JPlane6/Pulse/requirements_pi.txt

# ============================================================
#  PULSE — Raspberry Pi (Robot Client) Requirements
#
#  HOW TO INSTALL
#    If using a virtual environment (VENV):
#      pip install -r requirements_pi.txt
#
#    If installing globally to system packages:
#      pip install -r requirements_pi.txt --break-system-packages
# ============================================================

# ============================================================
#  PIP PACKAGES
# ============================================================

requests
# Sends audio data and history JSON structures to your Mac server.

pyserial
# Serial interface link between the Pi and the Arduino Mega motor driver.

RPLCD
# High-level character driver for the 20x4 I2C LCD screen.

smbus2
# Underpinning I2C system communication link for RPLCD layer calls.

sounddevice
# Handles safe 48kHz audio recordings from the USB headset mic.

scipy
# Downsamples audio streams dynamically to 16kHz via signal processing profiles.

numpy
# Array library facilitating multi-channel wave data processing.

opencv-python
# Retained fallback layer for image captures and diagnostic testing.

torch
# Required on the Pi to process local Silero VAD frame computations.

silero-vad
# Dynamic silence threshold iterator to eliminate fixed audio recording caps.

gpiod
# Allows Pi to use GPIO pins to run the status LEDs natively.

# ============================================================
#  CANNOT BE INSTALLED WITH PIP
#  Set these up manually before running client.py or main.py.
# ============================================================

# ------------------------------------------------------------
#  SYSTEM DEPENDENCIES & ALSA UTILITIES
# ------------------------------------------------------------
# Run these terminal operations to configure base image tools:
#   sudo apt-get update
#   sudo apt-get install -y i2c-tools python3-dev cmake swig libgfortran5 libatlas-base-dev libgpiod-dev aplay arecord

# ------------------------------------------------------------
#  I2C BUS CONFIGURATION (LCD Screen)
# ------------------------------------------------------------
# Interface configuration sequence:
#   sudo raspi-config -> Interface Options -> I2C -> Enable
#
# Hardware address line verification:
#   i2cdetect -y 1
#   (Should output matching cell '27')

# ------------------------------------------------------------
#  PIPER LOCAL TEXT-TO-SPEECH
# ------------------------------------------------------------
# Engine setup:
#   pip install piper-tts --break-system-packages
#
# Model payload components (Place inside /home/ayushs0604/Pulse/):
#   wget https://huggingface.co/rhasspy/piper-voices/resolve/main/en/en_US/amy/medium/en_US-amy-medium.onnx
#   wget https://huggingface.co/rhasspy/piper-voices/resolve/main/en/en_US/amy/medium/en_US-amy-medium.onnx.json

# ------------------------------------------------------------
#  YDLIDAR SCANNER DRIVER
# ------------------------------------------------------------
# Clone, configure, and install python bindings locally from source:
#   git clone https://github.com/YDLIDAR/YDLidar-SDK.git
#   cd YDLidar-SDK && mkdir build && cd build && cmake .. && make
#   cd .. && pip install . --break-system-packages

# ------------------------------------------------------------
#  UDEV TARGET RULES (/etc/udev/rules.d/99-pulse.rules)
# ------------------------------------------------------------
# Add these lines to ensure persistent device names across boots:
#   SUBSYSTEM=="tty", ATTRS{idVendor}=="10c4", ATTRS{idProduct}=="ea60", SYMLINK+="lidar"
#   SUBSYSTEM=="tty", ATTRS{idVendor}=="2341", ATTRS{idProduct}=="0042", SYMLINK+="arduino"
#
# Reload udev system paths:
#   sudo udevadm control --reload-rules && sudo udevadm trigger
