JPlane6/Pulse/client.py

import sounddevice as sd
import scipy.io.wavfile as wav
import scipy.signal as signal
import requests
import tempfile
import os
import re
import time
import subprocess
import json
import base64
import threading
from datetime import datetime
import numpy as np
import torch

# ═══════════════════════════════════════════════════════════════════
#  PI PERFORMANCE TUNING
# ═══════════════════════════════════════════════════════════════════
torch.set_num_threads(1)
torch.set_num_interop_threads(1)

# ═══════════════════════════════════════════════════════════════════
#  CONFIG
# ═══════════════════════════════════════════════════════════════════
SERVER_URL           = "http://192.168.0.157:5001"
MAX_QUESTIONS        = 6  # Matches server MAX_QUESTIONS
SAMPLERATE           = 16000
AUDIO_DEVICE_KEYWORD = "USB"
PIPER_MODEL          = "/home/ayushs0604/Pulse/en_US-hfc_female-medium.onnx"

# VAD tuning — optimized for natural conversation flow
VAD_THRESHOLD        = 0.85          # slightly lower = more sensitive
VAD_SILENCE_DURATION = 0.7           # faster cutoff for snappier responses
VAD_MAX_DURATION     = 12
VAD_FRAME_SAMPLES    = 512
RMS_GATE             = 120           # was 150 — catches quieter speech

# Urgency thresholds — single severe symptom triggers escalation
URGENT_THRESHOLD     = 1             # ANY urgent answer = urgent status
MONITOR_THRESHOLD    = 1             # ANY monitor answer = monitor status (unless urgent)

LED_RED_PIN   = 17
LED_GREEN_PIN = 27
LED_BLUE_PIN  = 22

LOG_DIR           = os.path.join(os.path.dirname(os.path.abspath(__file__)), "modules", "logs")
PATIENT_INFO_PATH = os.path.join(LOG_DIR, "patientINFO.json")
CONFIG_PATH       = os.path.join(os.path.dirname(os.path.abspath(__file__)), "modules", "config.json")

os.makedirs(LOG_DIR, exist_ok=True)

# ═══════════════════════════════════════════════════════════════════
#  VAD — loads in background so it doesn't block the greeting
# ═══════════════════════════════════════════════════════════════════
vad_model  = None
_vad_ready = threading.Event()

def _load_vad_bg():
    global vad_model
    print("[vad] Loading Silero VAD...")
    from silero_vad import load_silero_vad
    vad_model = load_silero_vad()
    _vad_ready.set()
    print("[vad] Ready.")

threading.Thread(target=_load_vad_bg, daemon=True).start()

# ═══════════════════════════════════════════════════════════════════
#  GPIO
# ═══════════════════════════════════════════════════════════════════
GPIO_AVAILABLE = False
RED_LINE = GREEN_LINE = BLUE_LINE = None

try:
    import gpiod
    target_chip = "gpiochip0"
    if not os.path.exists("/dev/gpiochip0") and os.path.exists("/dev/gpiochip4"):
        target_chip = "gpiochip4"
    LED_CHIP   = gpiod.Chip(target_chip)
    RED_LINE   = LED_CHIP.get_line(LED_RED_PIN)
    GREEN_LINE = LED_CHIP.get_line(LED_GREEN_PIN)
    BLUE_LINE  = LED_CHIP.get_line(LED_BLUE_PIN)
    RED_LINE.request(consumer="PULSE",   type=gpiod.LINE_REQ_DIR_OUT)
    GREEN_LINE.request(consumer="PULSE", type=gpiod.LINE_REQ_DIR_OUT)
    BLUE_LINE.request(consumer="PULSE",  type=gpiod.LINE_REQ_DIR_OUT)
    RED_LINE.set_value(0); GREEN_LINE.set_value(0); BLUE_LINE.set_value(0)
    GPIO_AVAILABLE = True
    print(f"[gpio] Linked via {target_chip}")
except Exception as e:
    print(f"[gpio] Bypassed ({e}). Simulation mode.")


def set_status_led(status_type):
    if not GPIO_AVAILABLE:
        print(f"[led] {status_type}")
        return
    try:
        RED_LINE.set_value(0); GREEN_LINE.set_value(0); BLUE_LINE.set_value(0)
        if status_type == "URGENT":    RED_LINE.set_value(1)
        elif status_type == "MONITOR": BLUE_LINE.set_value(1)
        else:                          GREEN_LINE.set_value(1)
    except Exception as e:
        print(f"[gpio] LED error: {e}")


# ═══════════════════════════════════════════════════════════════════
#  AUDIO DEVICE CACHE
# ═══════════════════════════════════════════════════════════════════
_native_sr       = None
_pa_device_index = None
_resample_up     = None
_resample_down   = None
_alsa_device     = None


def find_alsa_device():
    try:
        result = subprocess.run(["aplay", "-l"], capture_output=True, text=True, timeout=1)
        for line in result.stdout.splitlines():
            if AUDIO_DEVICE_KEYWORD.lower() in line.lower() and line.startswith("card"):
                m = re.search(r"card (\d+):", line)
                if m:
                    d = f"plughw:{m.group(1)},0"
                    print(f"[audio] ALSA: {d}")
                    return d
    except Exception:
        pass
    return None


def find_portaudio_input_device():
    for i, dev in enumerate(sd.query_devices()):
        if AUDIO_DEVICE_KEYWORD.lower() in dev["name"].lower() and dev["max_input_channels"] > 0:
            return i
    return None


def init_audio_cache(alsa_dev, pa_index):
    global _native_sr, _resample_up, _resample_down, _pa_device_index, _alsa_device
    _alsa_device     = alsa_dev
    _pa_device_index = pa_index
    info             = sd.query_devices(pa_index, "input")
    _native_sr       = int(info["default_samplerate"])
    from math import gcd
    g              = gcd(SAMPLERATE, _native_sr)
    _resample_up   = SAMPLERATE  // g
    _resample_down = _native_sr  // g
    print(f"[audio] Native={_native_sr}Hz  resample {_native_sr}→{SAMPLERATE}")


def check_server():
    try:
        r = requests.get(f"{SERVER_URL}/ping", timeout=1)
        return r.status_code == 200
    except Exception:
        return False


def load_config():
    if os.path.exists(CONFIG_PATH):
        with open(CONFIG_PATH) as f:
            return json.load(f)
    return {}

def save_config(cfg):
    with open(CONFIG_PATH, "w") as f:
        json.dump(cfg, f, indent=2)

def get_room_number(cfg):  return str(cfg.get("room_number", "101")).strip()
def get_patient_name(cfg): return "".join(w.capitalize() for w in cfg.get("patient_name", "Patient").strip().split())


# ═══════════════════════════════════════════════════════════════════
#  TTS
#
#  Both functions use a fresh Piper+aplay pair per call.
#  aplay.wait() is a real OS signal — no sleep guessing.
#  0.2s pause after is just a natural breath gap.
# ═══════════════════════════════════════════════════════════════════

def _open_pipeline():
    piper = subprocess.Popen(
        ["piper", "--model", PIPER_MODEL, "--output_raw"],
        stdin=subprocess.PIPE,
        stdout=subprocess.PIPE,
        stderr=subprocess.DEVNULL
    )
    aplay = subprocess.Popen(
        ["aplay", "-D", _alsa_device, "-r", "22050", "-f", "S16_LE", "-c", "1"],
        stdin=piper.stdout,
        stdout=subprocess.DEVNULL,
        stderr=subprocess.DEVNULL
    )
    return piper, aplay


def _close_pipeline(piper, aplay):
    try:
        piper.stdin.close()
    except Exception:
        pass
    aplay.wait()    # blocks until audio is fully played — guaranteed done
    piper.wait()
    time.sleep(0.2) # short breath pause before mic opens


def speak_plain(text):
    """Blocking TTS. Does not return until audio is fully played."""
    if not text.strip():
        return
    print(f"[tts] '{text}'")
    piper, aplay = _open_pipeline()
    try:
        piper.stdin.write((text.strip() + "\n").encode("utf-8"))
    except BrokenPipeError:
        pass
    _close_pipeline(piper, aplay)


def speak_stream(sse_response):
    """
    Streams SSE tokens from /turn_stream into Piper as they arrive.
    Flushes to Piper only on sentence-ending punctuation so Piper gets
    full sentence context for natural prosody — no word-by-word feeding.
    Waits for aplay to drain before returning.

    Returns (transcribed_text, status, next_question).
    The next_question is NOT spoken here — caller decides what to do with it.
    """
    text     = ""
    status   = "STABLE"
    question = "DONE"

    MUTE_SIGNALS = [
        "done", "if all", "all covered", "topics covered",
        "output done", "output: done", "no further", "no more",
        "question:", "rules:", "conversation:", "nurse:", "patient:"
    ]

    piper, aplay = _open_pipeline()
    buf = ""

    def _flush(chunk):
        chunk = chunk.strip()
        if not chunk:
            return
        for sig in MUTE_SIGNALS:
            if sig in chunk.lower():
                print(f"[tts-stream] muted: '{chunk}'")
                return
        print(f"[tts-stream] → '{chunk}'")
        try:
            piper.stdin.write((chunk + " ").encode("utf-8"))
            piper.stdin.flush()
        except BrokenPipeError:
            pass

    try:
        for raw_line in sse_response.iter_lines():
            if not raw_line:
                continue
            line = raw_line.decode("utf-8") if isinstance(raw_line, bytes) else raw_line
            if not line.startswith("data: "):
                continue
            try:
                evt = json.loads(line[6:])
            except Exception:
                continue

            if evt.get("done"):
                text     = evt.get("text",     "")
                status   = evt.get("status",   "STABLE")
                question = evt.get("question", "DONE")
                break

            token = evt.get("t", "")
            if not token:
                continue

            buf += token

            # Only flush on sentence boundaries — Piper needs context
            if buf.rstrip()[-1:] in ".?!":
                _flush(buf)
                buf = ""

    except Exception as e:
        print(f"[tts-stream] error: {e}")

    if buf.strip():
        _flush(buf)

    _close_pipeline(piper, aplay)
    
    # Print transcription immediately before returning
    if text.strip():
        print(f"[transcription] '{text}'")
    
    return text, status, question


def consume_stream_silent(sse_response):
    """Drains SSE stream without speaking. Returns (text, status, question)."""
    text     = ""
    status   = "STABLE"
    question = "DONE"
    try:
        for raw_line in sse_response.iter_lines():
            if not raw_line:
                continue
            line = raw_line.decode("utf-8") if isinstance(raw_line, bytes) else raw_line
            if not line.startswith("data: "):
                continue
            try:
                evt = json.loads(line[6:])
            except Exception:
                continue
            if evt.get("done"):
                text     = evt.get("text",     "")
                status   = evt.get("status",   "STABLE")
                question = evt.get("question", "DONE")
                break
    except Exception as e:
        print(f"[stream] error: {e}")
    
    # Print transcription immediately before returning
    if text.strip():
        print(f"[transcription] '{text}'")
    
    return text, status, question


# ═══════════════════════════════════════════════════════════════════
#  RECORD
#
#  Starts listening immediately after TTS finishes (aplay.wait() means
#  we're already done speaking). 300ms settling eats any room reverb.
#  Returns as soon as 0.8s of silence detected — much snappier than 1.2s.
# ═══════════════════════════════════════════════════════════════════

def record(silence_duration=VAD_SILENCE_DURATION, max_duration=VAD_MAX_DURATION):
    if not _vad_ready.is_set():
        print("[mic] Waiting for VAD...")
        _vad_ready.wait()

    hw_blocksize        = int(VAD_FRAME_SAMPLES * (_native_sr / SAMPLERATE))
    silence_frames_need = int(silence_duration * _native_sr / hw_blocksize)
    max_frames          = int(max_duration * _native_sr / hw_blocksize)
    # 300ms settling — eats room reverb from TTS, but starts fast
    settling_frames     = int(0.3 * _native_sr / hw_blocksize)

    frames           = []
    silent_frames    = 0
    started_speaking = False
    frame_count      = 0

    print("[mic] Listening...")

    try:
        with sd.InputStream(samplerate=_native_sr, channels=1, dtype="int16",
                            device=_pa_device_index, blocksize=hw_blocksize) as stream:
            for _ in range(max_frames):
                raw, _  = stream.read(hw_blocksize)
                frame   = raw.flatten()
                frame_count += 1

                # Discard settling frames without appending
                if frame_count <= settling_frames:
                    continue

                if frame_count == settling_frames + 1:
                    print("[mic] Ready.")

                frames.append(frame.copy())

                rms = np.sqrt(np.mean(frame.astype(np.float32) ** 2))
                if rms < RMS_GATE:
                    if started_speaking:
                        silent_frames += 1
                        if silent_frames >= silence_frames_need:
                            print("[mic] Silence — done.")
                            break
                    continue

                f32       = frame.astype(np.float32) / 32768.0
                resampled = signal.resample_poly(f32, _resample_up, _resample_down)
                conf      = vad_model(torch.from_numpy(resampled).float(), SAMPLERATE).item()

                if conf > VAD_THRESHOLD:
                    started_speaking = True
                    silent_frames    = 0
                elif started_speaking:
                    silent_frames += 1
                    if silent_frames >= silence_frames_need:
                        print("[mic] End of speech.")
                        break

    except Exception as e:
        print(f"[mic] Error: {e}")
        return b""

    if not frames:
        return b""

    audio_raw = np.concatenate(frames, axis=0)
    audio_16k = signal.resample_poly(
        audio_raw.astype(np.float32), _resample_up, _resample_down
    ).astype(np.int16)

    with tempfile.NamedTemporaryFile(suffix=".wav", delete=False) as f:
        wav.write(f.name, SAMPLERATE, audio_16k)
        path = f.name
    with open(path, "rb") as f:
        data = f.read()
    os.remove(path)
    return data


# ═══════════════════════════════════════════════════════════════════
#  SERVER CALLS
# ═══════════════════════════════════════════════════════════════════

_http_session = requests.Session()

def turn_stream(audio_bytes, history):
    try:
        payload = {
            "audio_b64": base64.b64encode(audio_bytes).decode(),
            "history":   history
        }
        r = _http_session.post(
            f"{SERVER_URL}/turn_stream",
            json=payload,
            stream=True,
            timeout=60
        )
        return r
    except Exception as e:
        print(f"[turn_stream] error: {e}")
        return None


def check_urgent(history):
    try:
        r = _http_session.post(
            f"{SERVER_URL}/flag_urgent",
            json={"history": history},
            timeout=60
        )
        return r.json()["flagged_urgent"]
    except Exception:
        return False


# ═══════════════════════════════════════════════════════════════════
#  TRIAGE STATUS LOGIC
#
#  Single urgent or monitor classification immediately escalates status.
#  URGENT overrides MONITOR. Status can only go up, never down.
# ═══════════════════════════════════════════════════════════════════

def compute_session_status(history):
    urgent_count  = sum(1 for qa in history if qa.get("status") == "URGENT")
    monitor_count = sum(1 for qa in history if qa.get("status") == "MONITOR")
    if urgent_count >= URGENT_THRESHOLD:
        return "URGENT"
    if monitor_count >= MONITOR_THRESHOLD:
        return "MONITOR"
    return "STABLE"


# ═══════════════════════════════════════════════════════════════════
#  LCD
# ═══════════════════════════════════════════════════════════════════

def init_lcd():
    try:
        from RPLCD.i2c import CharLCD
        lcd = CharLCD("PCF8574", 0x27, cols=20, rows=4)
        lcd.clear()
        return lcd
    except Exception:
        return None


def show_error_on_lcd(lcd, line2, line3):
    if not lcd: return
    lcd.clear()
    lcd.cursor_pos = (0, 0); lcd.write_string("!! SERVICE NEEDED !!")
    lcd.cursor_pos = (2, 0); lcd.write_string(line2.center(20)[:20])
    lcd.cursor_pos = (3, 0); lcd.write_string(line3.center(20)[:20])


def show_status_on_lcd(lcd, status, flagged):
    if not lcd: return
    lcd.clear()
    lcd.cursor_pos = (0, 0); lcd.write_string("== TRIAGE STATUS ==")
    lcd.cursor_pos = (2, 0)
    if status == "URGENT":    lcd.write_string(">>  !! URGENT !!  <<")
    elif status == "MONITOR": lcd.write_string(">>    MONITOR     <<")
    else:                     lcd.write_string(">>    STABLE      <<")
    lcd.cursor_pos = (3, 0)
    lcd.write_string("!! NURSE ALERTED !!" if flagged else "Assessment complete")


# ═══════════════════════════════════════════════════════════════════
#  LOGGING
# ═══════════════════════════════════════════════════════════════════

def save_log(session_dir, record_data):
    os.makedirs(session_dir, exist_ok=True)
    with open(os.path.join(session_dir, "log.json"), "w") as f:
        json.dump(record_data, f, indent=2)
    all_records = []
    if os.path.exists(PATIENT_INFO_PATH):
        try:
            content = open(PATIENT_INFO_PATH).read().strip()
            if content:
                all_records = json.loads(content)
        except Exception:
            pass
    all_records.append(record_data)
    with open(PATIENT_INFO_PATH, "w") as f:
        json.dump(all_records, f, indent=2)
    print(f"[log] {len(all_records)} total records.")


# ═══════════════════════════════════════════════════════════════════
#  STATUS ANNOUNCEMENT
# ═══════════════════════════════════════════════════════════════════

STATUS_PHRASES = {
    "URGENT":  "Its urgent, I'm calling a nurse right now. Help is on the way.",
    "MONITOR": "No worries, A nurse will monitor you soon.",
    "STABLE":  "You have been marked as STABLE. Have a great day. Call if you need anything.",
}

def announce_status(patient_name, status, flagged):
    phrase = STATUS_PHRASES["URGENT" if (flagged or status == "URGENT") else status]
    speak_plain(f"{patient_name}, {phrase}")


# ═══════════════════════════════════════════════════════════════════
#  MAIN
#
#  Q1: speak greeting → record → turn_stream → speak_stream speaks
#      the AI's first follow-up question live. next_q comes back from
#      speak_stream but is NOT spoken yet.
#
#  Q2-Q6: speak_plain(next_q) immediately (no server wait) → record
#      → turn_stream → consume_stream_silent (silent, just get next_q)
#
#  This means: patient hears each question the moment the previous
#  answer is processed, with no extra gap.
#
#  Exit conditions:
#    - AI returns DONE (all info collected — clean exit)
#    - MAX_QUESTIONS reached
#    - Server unreachable
# ═══════════════════════════════════════════════════════════════════

def main():
    print("[init] Starting Pulse...")
    
    # Load config early for cached devices
    cfg = load_config()
    
    # ── Hardware discovery (with caching & parallel server check) ──
    lcd = init_lcd()
    if lcd:
        lcd.write_string("PULSE BOOTING...")
    
    # Try cached device first
    alsa_device = None
    pa_input_index = None
    cached_alsa = cfg.get("cached_alsa_device")
    cached_pa_idx = cfg.get("cached_pa_index")
    
    if cached_alsa and cached_pa_idx is not None:
        try:
            # Quick validation of cached device
            info = sd.query_devices(cached_pa_idx, "input")
            if info and AUDIO_DEVICE_KEYWORD.lower() in info["name"].lower():
                alsa_device = cached_alsa
                pa_input_index = cached_pa_idx
                print(f"[audio] Using cached ALSA: {alsa_device}")
        except Exception:
            pass
    
    # Fall back to discovery if cache failed
    if alsa_device is None:
        print("[audio] Discovering devices...")
        alsa_device = find_alsa_device()
        if alsa_device is None:
            print("[main] FATAL: No ALSA output found.")
            return
        
        pa_input_index = find_portaudio_input_device()
        if pa_input_index is None:
            show_error_on_lcd(lcd, "MIC NOT FOUND", "Check Hardware")
            speak_plain("I cannot find the microphone input.")
            return
        
        # Cache the devices for next run
        cfg["cached_alsa_device"] = alsa_device
        cfg["cached_pa_index"] = pa_input_index
        save_config(cfg)
    
    global _alsa_device
    _alsa_device = alsa_device
    init_audio_cache(alsa_device, pa_input_index)
    
    # Check server in parallel during audio setup (already done above)
    print("[server] Checking connection...")
    server_ok = check_server()
    if not server_ok:
        show_error_on_lcd(lcd, "SERVER OFFLINE", "Check Laptop")
        speak_plain("I cannot connect to my brain server.")
        return
    print("[server] Connected.")

    room         = get_room_number(cfg)
    patient_name = get_patient_name(cfg)
    date         = datetime.now().strftime("%m/%d/%Y")
    time_str     = datetime.now().strftime("%I:%M%p")
    session_dir  = os.path.join(LOG_DIR, f"{date.replace('/','-')}_{time_str}_Room{room}_{patient_name}")

    if lcd:
        lcd.clear()
        lcd.write_string("PULSE READY")

    set_status_led("STABLE")

    history = []
    status  = "STABLE"
    
    # Start with first question
    current_q = f"Hello {patient_name}! I am Pulse. What's bothering you today?"

    # ── Q1-Q6 Simple Loop ──────────────────────────────────────────
    for i in range(MAX_QUESTIONS):
        print(f"\n--- Q{i+1}/{MAX_QUESTIONS} ---")
        
        # 1. Ask the question
        speak_plain(current_q)
        
        # 2. Listen for answer
        audio = record()
        sse = turn_stream(audio, history)
        if sse is None:
            print("[main] Server unreachable.")
            break
        
        # 3. Get transcription, status, and next question (silent processing)
        answer, answer_status, next_q = consume_stream_silent(sse)
        
        # 4. Save to history
        history.append({"q": current_q, "a": answer, "status": answer_status})
        status = compute_session_status(history)
        set_status_led(status)
        print(f"[status] {status}  (urgent={sum(1 for q in history if q['status']=='URGENT')} monitor={sum(1 for q in history if q['status']=='MONITOR')})")
        
        # 5. Check if done
        if not next_q or next_q.strip().upper() == "DONE":
            print("[main] AI signalled DONE — all info collected.")
            break
        
        # 6. Prepare next question
        current_q = next_q

    # ── Final decision ─────────────────────────────────────────────
    print("\n--- Finalizing ---")
    
    # If AI ended early (emergency) and there's any urgent signal, force URGENT
    if len(history) <= 2 and any(qa.get("status") == "URGENT" for qa in history):
        print("[main] Early exit with urgent symptoms — escalating to URGENT")
        status = "URGENT"
    
    # Final safety check
    flagged = check_urgent(history)
    if flagged:
        status = "URGENT"

    set_status_led(status)
    announce_status(patient_name, status, flagged)
    show_status_on_lcd(lcd, status, flagged)

    save_log(session_dir, {
        "header":     {"patient_name": patient_name, "room": room, "date": date, "time": time_str},
        "triage":     {"final_status": status, "flagged_urgent": flagged},
        "assessment": history
    })
    print(f"[main] Done. Status={status} Flagged={flagged}")


if __name__ == "__main__":
    try:
        main()
    finally:
        if GPIO_AVAILABLE:
            try:
                RED_LINE.set_value(0); GREEN_LINE.set_value(0); BLUE_LINE.set_value(0)
                RED_LINE.release();    GREEN_LINE.release();    BLUE_LINE.release()
            except Exception:
                pass
