JPlane6/Pulse/lcd_hello.py

from RPLCD.i2c import CharLCD
import time

lcd = CharLCD('PCF8574', 0x27, cols=20, rows=4)

def hello():
    try:
        lcd.clear()
        lcd.cursor_pos = (0, 0)
        lcd.write_string("HELLO EVERYONE, ")
        lcd.cursor_pos = (1, 0)
        lcd.write_string("I AM PULSE!")
        lcd.cursor_pos = (2, 0)
        lcd.write_string("BY THE")
        lcd.cursor_pos = (3, 0)
        lcd.write_string("BRAINY BADGERS!")
        time.sleep(3)
        lcd.clear()

    except Exception as e:
        print(f"Could not connect to LCD: {e}")

if __name__ == "__main__":
    hello() 
