JPlane6/Pulse/(commit log)

2026-02-10 THIS CODE ONLY WORKS WHEN SSHed INTO THE RASPBERRY PI
2026-02-16 Added requirements.txt files for the arduino and pi dependencies
2026-02-16 Daivik's LiDAR Test code. Transfered it into a seperate branch for simplicity in the Repo
2026-02-19 Renamed file to PULSE_Lidar_Test1.py on LiDAR branch
2026-02-25 Made a requirements_laptop.txt for the dependencies needed on the pc and updated requirements_pi.txt with those needed for comminicating with the pc and making sense of the camera
2026-04-03 Test for running the motors along with a library to make it simpler to use like you wuld on a arduino style microcontroller but on rasberry pi.
2026-04-03 Tried a different Approach to Move the Motors
    I tried using the raspberry pi to talk to the Arduino uno, which will turn the motors. This might work better and has a lot less risk.
2026-04-03 Tried a different Approch to Control the Motors
    This is the Arduino Aspect of the Program which keeps the serial port open for commands from the pi and executes them.
2026-04-03 made the method run all the motors forward or backward
2026-04-03 Made the Arduino accept commands from serial port. Tested it by sending Data from Serial Moniter(accesible on Arduino IDE) and it worked
2026-04-03 Made the PiToArduinoControl.py file so the the pi can communicate with the arduino to move the motors and the robot. Also added a requirements_pi and a requirements_arduino which has the dependacies 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
2026-04-03 Move motorControl_Arduino.ino into folder
    Reorganize repository by moving motorControl_Arduino.ino into the motorControl_Arduino/ subdirectory. This is a pure rename (no content changes) to comply with Arduino IDE requierments
2026-04-03 Refactor motor control to non-blocking state machine
    Remap motor instances and replace blocking delay-based motion with a non-blocking state machine using millis(). Added State enum and tracking variables (targetSpeed, currentRampSpeed, runDuration, timestamps) plus helper functions setAllSpeed(), stopAll(), releaseAll(). MOVE and TURN now initiate ramp-up → run → ramp-down sequences and return immediately; loop() drives speed ramps in background. Added STOP/GO commands to lock/unlock motion and serial status messages (READY, MOVING, TURNING, STOPPED, LOCKED, UNLOCKED, DONE). Removed per-step delay()/blocking loops from moveAll() and turn(), preserving gradual ramping behavior. Also adde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
    [motorControl_Arduino.ino]
2026-04-03 Refactor motor control logic and improve command handling in Arduino and Pi scripts. Added Emergancy STOP function and made code more abstract
2026-04-03 Add .gitignore to ignore .DS_Store
    Add a .gitignore entry to ignore macOS .DS_Store files. The diff also includes an updated .DS_Store binary currently tracked in the repo; note that adding .gitignore does not untrack existing files—run `git rm --cached .DS_Store` if you want to stop tracking the file.
2026-04-03 Add error handling for Arduino connection in motorControl_Pi.py
    [motorControl_Pi.py]
2026-04-03 Add user interruption handling in motorControl_Pi.py
2026-04-03 Add SerialSend.py for Arduino communication and command handling
2026-04-03 Tried making a basic function to combine the motors and LiDAR. Didnt rlly work too well. need t owork with Daivik.
2026-04-21 Add files via upload
    these do not work, many errors. need to work on the driver and main file to implement lidar with motors.
    [main.py]
2026-04-25 Update .gitignore, refactor driver.py, and implement lidar functionality in motorControl_Pi.py
2026-04-25 Refactor lcd_hello.py to improve greeting message and update main.py to adjust lidar distance calculations and initialization
2026-04-25 Integrate motor control functionality into main.py and enable movement commands
2026-04-26 Refactor lidar and motor control integration in main.py; add obstacle detection and update movement logic
2026-04-30 Fix typo in is_obstacle_ahead function and implement get_left_right_distances_cm for improved distance measurement
    [lidarHelpers.py, main.py]
2026-05-05 Merged vision (yolo) with Lidar main to make them work together. Added yolo26x.pt training weights to .gitignore
2026-05-06 Enhance LIDAR and patient interaction features; update .gitignore, add visual triage and speech recognition modules, and refactor main logic for improved obstacle handling and patient check-in proces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
2026-05-10 tried using claude to fix logic(didnt rlly work) will try again tmrw
    [lidarHelpers.py, main.py, motorControl_Pi.py]
2026-05-16 Refactor LIDAR parameters for consistency; add LiDAR test script for distance measurement
2026-05-16 Refactor LIDAR distance detection logic; unify distance retrieval in one pass and update obstacle handling in main loop
2026-05-16 Update LCD greeting message and improve LIDAR distance processing; fix constants and add stable distance averaging function
    [lcd_hello.py, lidarHelpers.py, main.py, motorControl_Pi.py]
2026-05-16 Refactor LIDAR configuration and detection logic; update distance thresholds and add gallery navigation script
2026-05-17 Fix turn function logic for motor control; correct direction handling for left and right turns
    [motorControl_Arduino.ino]
2026-05-17 Update requirements for laptop and Raspberry Pi; streamline dependencies and add new libraries for audio processing and AI integration
2026-05-17 Update .gitignore to include TTS model files; add client.py for audio processing and patient interaction
2026-05-19 Update device ports for LIDAR and Arduino; adjust turn speed for improved motor control
2026-05-19 Update audio sampling rate and resampling logic; adjust LIDAR port and constants for improved navigation
2026-05-20 Add patient assessment functionality and configuration management
    - Implemented subprocess to launch client.py for patient assessment after entering a room.
    - Added configuration loading and saving functions to manage room number and patient name.
    - Created config.json to store patient-related settings.
2026-05-21 Refactor audio device detection and server health check; improve error handling and logging
    [client.py]
2026-05-22 Update server URL to port 5001 and fix speech output message formatting
    [client.py]
2026-05-22 Update motor turn speed to maximum; enhance server code organization and add health check endpoint
2026-05-22 Revise Raspberry Pi requirements and installation notes
    Updated requirements for Raspberry Pi with installation instructions and added comments for clarity.
2026-05-25 Refactor requirements and server code for clarity and performance
    - Updated `requirements_laptop.txt` and `requirements_pi.txt` to streamline package descriptions and installation instructions.
    - Enhanced comments for better understanding of package roles and installation steps.
    - Improved server.py by refining model loading messages, triage assessment logic, and API response handling.
    - Optimized prompts for the AI model to reduce latency and improve response accuracy.
    - Added error handling improvements and clarified log messages for better debugging.
    [client.py, server.py]
2026-05-25 Enhance hardware integration and audio processing; add GPIO setup, LED control, and microphone calibration features
2026-05-25 Enhance GPIO integration for Raspberry Pi 5; update LED control to use gpiod and add VAD tuning parameters
2026-05-26 Disable barge-in interruption feature for improved control during audio processing
2026-05-26 Update patient name in config; adjust obstacle threshold and side distance for improved navigation
2026-05-26 Update model references in .gitignore and client.py; switch to en_US-hfc_female-medium model for TTS
2026-05-27 Update VAD_THRESHOLD in client.py for improved voice activity detection; enhance patient assessment handling in main.py with triage result display and navigation halt
2026-05-27 Adjust patient farewell message in client.py and modify ENTER_SPEED in main.py for smoother navigation
2026-05-27 Add Piper warmup function to reduce initial speech delay; refactor main boot process for parallel initialization of LCD, Arduino, and LiDAR
2026-05-27 Refactor triage logic in server.py: streamline keyword classification, consolidate assess and next question endpoints, and enhance error handling for AI responses.
    [server.py]
2026-05-27 Refactor main.py: enhance triage system with VAD initialization, GPIO controls, audio processing, and server communication; improve logging and error handling.
    [main.py]
2026-05-28 Revert main.py cause new code wasnt working well. will try to fix it again tmrw.
    [main.py]
2026-05-28 Refactor motor control and server logic for improved performance and readability
    - Updated motorControl_Pi.py to streamline command sending and response handling.
    - Reduced timeout values for wait functions to enhance responsiveness.
    - Simplified print statements for clarity.
    - Enhanced moveUntilThreshold function to provide better feedback on distance.
    - Refactored server.py to improve audio processing and error handling.
    - Introduced new helper functions for cleaner code structure.
    - Improved keyword classification logic for triage assessment.
    - Updated API endpoints to handle requests more robustly and return clearer responses.
    [client.py, main.py, motorControl_Pi.py, server.py]
2026-05-28 Add streaming support for phi3 model in turn endpoint; implement real-time TTS with SSE and enhance error handling
    [server.py]
2026-05-28 Refactor client.py and server.py: streamline VAD loading, improve TTS question generation, and enhance error handling for audio processing
    [client.py, server.py]
2026-05-29 Update prompt for hand placement in LiDAR test
2026-05-30 Optimize VAD parameters for improved responsiveness, enhance urgency classification logic, and implement caching for audio devices in configuration
2026-05-31 FIXED SERVER FOR ACCURATE QS!!!!
    [lcd_hello.py, server.py]
